martyvona/petc/arduino-uno-pinout-diagram.pdf

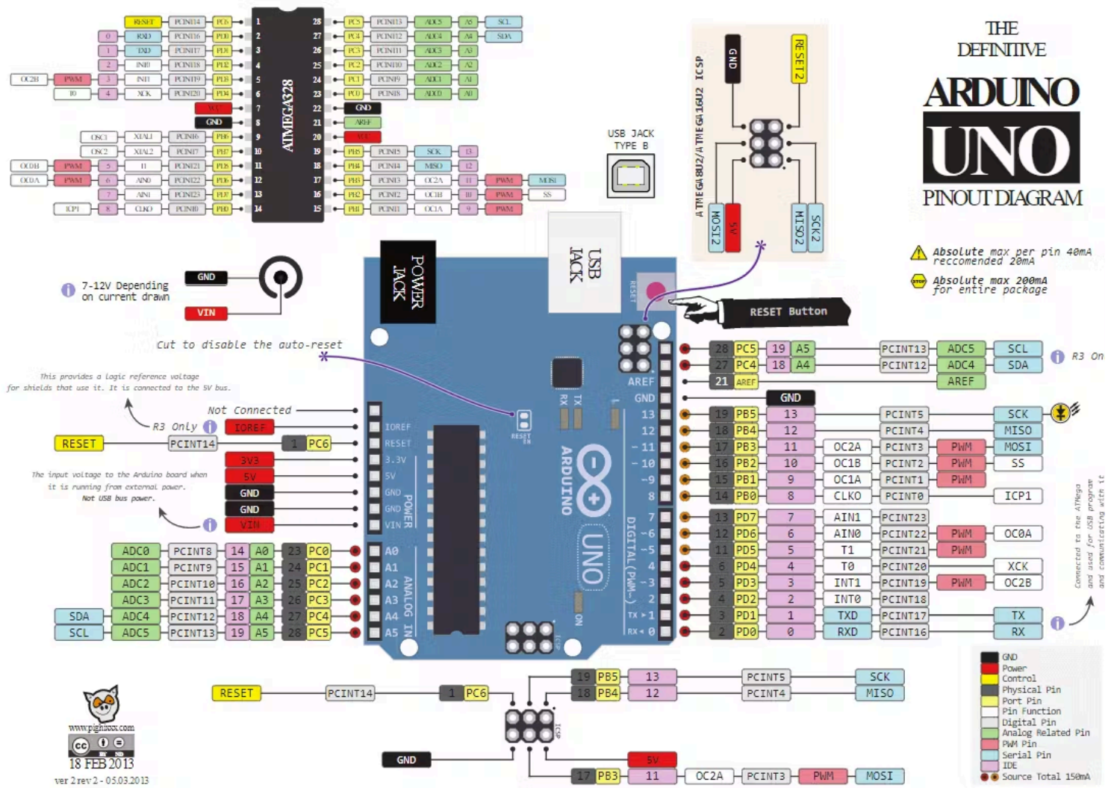
[picture p14: page 1]
