martyvona/petc/photos/petc_schematic.jpg

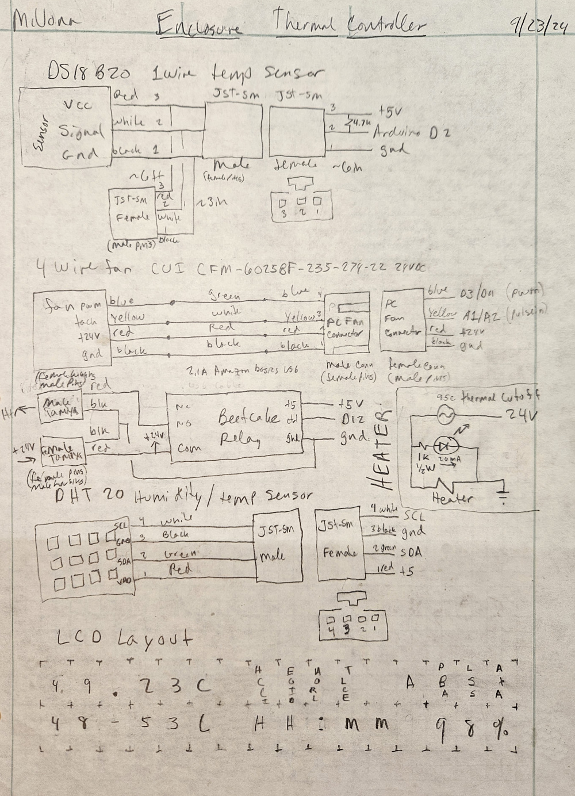
photos/petc_schematic.jpg
