martyvona/petc/(commit log)

2024-11-06 add BOM, description, and cutaway image
2024-11-06 more BOM and photos
2024-11-07 add schematic
2024-11-13 update heater mount
2024-11-20 add photos and doc for cooling fan
2024-11-20 circulate instead of idle in heat mode; only force idle mode instead of heat mode if timer is not running or temperature is not detected
2024-11-21 tweak temps, circ instead of idle while recovering in heat profile
2024-11-21 add bed preheat gcode
2024-11-22 clarify sensor mounting
2024-11-22 add heatup info
2024-11-22 update bed preheat gcode
2024-12-05 add button input timeout
2024-12-05 bugfix button increment to max temp
    [petc.ino]
2025-02-16 exit MANUAL mode when (re)starting timer
2025-07-01 add arduino pinout diagram
2025-07-01 use angle bracket include instead of double quotes
2025-07-13 add snorkle tube lengths
2025-11-05 lower temps for tpu and pla profiles to effectively run fan continuously
2025-11-05 use incr() and decr() for current_input
